plasmasparc/ArduPilot-TiltLink/docs/hardware/images/Handheld transmitter.jpg

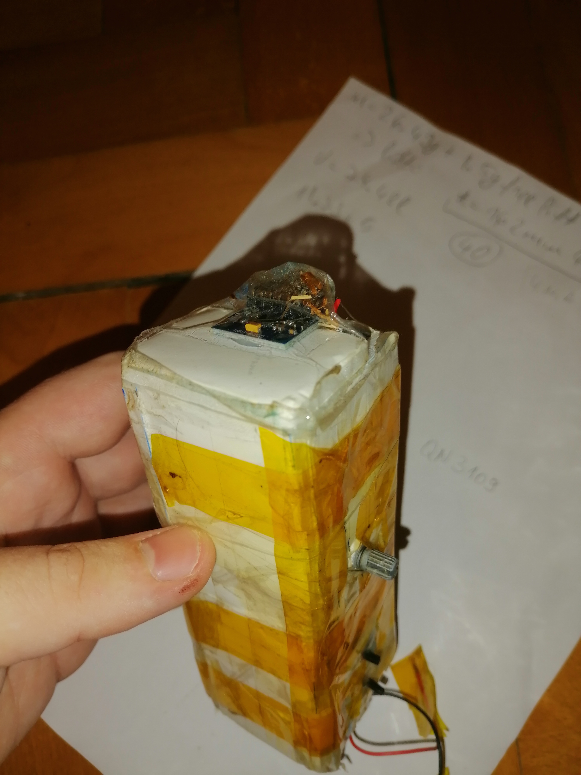
docs/hardware/images/Handheld transmitter.jpg
