plasmasparc/ArduPilot-TiltLink/docs/hardware/images/Ground-station.jpg

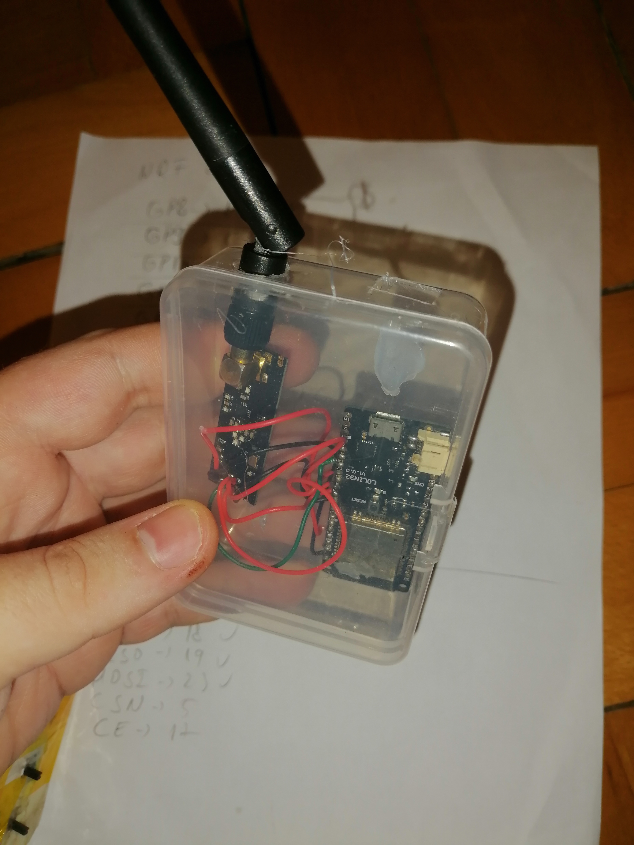
docs/hardware/images/Ground-station.jpg
