plasmasparc/ArduPilot-TiltLink/docs/hardware/images/F405-frame.jpg

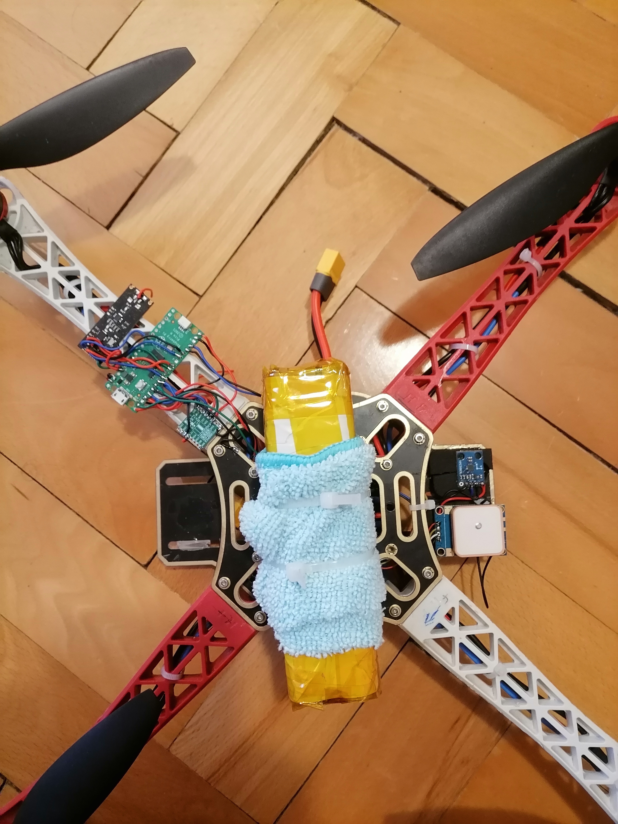
docs/hardware/images/F405-frame.jpg
