plasmasparc/ArduPilot-TiltLink/(commit log)

2026-08-05 LoRa RC - Control frame
2026-08-05 MAVLink nRF24 GND
2026-08-05 FC - Ardupilot - UART - ports
2026-08-05 Ground station - HW wiering
2026-08-05 Handheld transmitter - HW wiring
2026-08-05 Ground station - HW wiring
2026-08-05 Air node - HW wiring
2026-08-05 GROUND MAVLink station - src
